MR-DOS/kicad-lib/lib_own/libtest.kicad_pcb

## KiCad design lib_own/libtest.kicad_pcb (2018-01-04, last stored version)

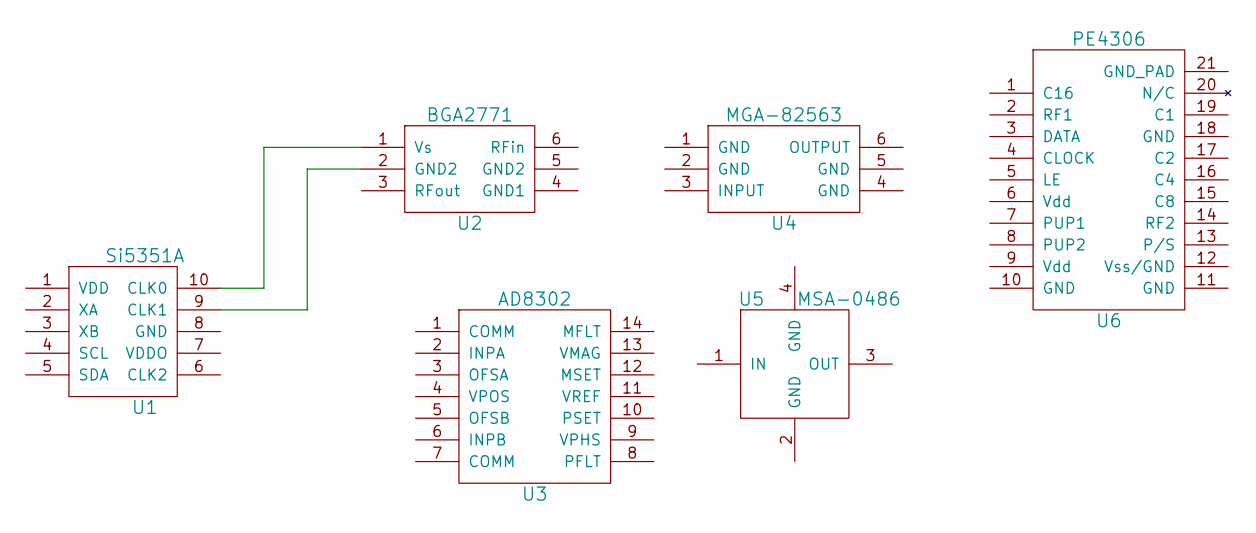
[picture p1: schematic libtest.sch]

Parts:
U1: Si5351A; MSOP-10_3x3mm_Pitch0.5mm
U2: BGA2771; SOT363(TSSOP6)
U3: AD8302; TSSOP-14_4.4x5mm_Pitch0.65mm
U4: MGA-82563; SOT363(TSSOP6)
U5: MSA-0486; 86_PLASTIC_PACKAGE
U6: PE4306; QFN-20-1EP_4x4mm_Pitch0.5mm

Connections:
unnamed: U1.9 (CLK1), U2.2 (GND2)
unnamed: U1.10 (CLK0), U2.1 (Vs)

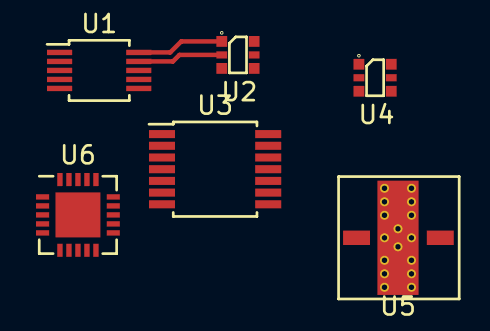
[picture p2: board libtest.kicad_pcb from above]

Board: 2 copper layers, 6 parts (0 on the bottom side), 2 nets.
