MR-DOS/kicad-lib/(commit log)

2018-01-04 Initial library commit
    [lib_petr_inherited.kicad_pcb, lib_petr_inherited.sch, libtest.kicad_pcb, libtest.sch]
2021-12-16 Removed old libraries, added new ones.
    [lib_petr_inherited.kicad_pcb, lib_petr_inherited.sch, libtest.kicad_pcb, libtest.sch]
2022-01-02 Added 300mA version of XC6204
2023-03-14 Added all devices from guitar_down_octave
2023-03-16 Added devices from all projects, starting with recovery of old libraries which broke due to bug in v6-nightly (rounding of coordinates).
2023-03-16 Started merging old library before v6 rounding bug (currently stopped at ICS501).
2023-03-20 Merged with old v6 nightly library (broken due to rounding bug). Footprints need checking.
